lorenzopampaloni/Heliostat-system/hardware/photos/electronics_photos/arduino_and_drivers.JPG

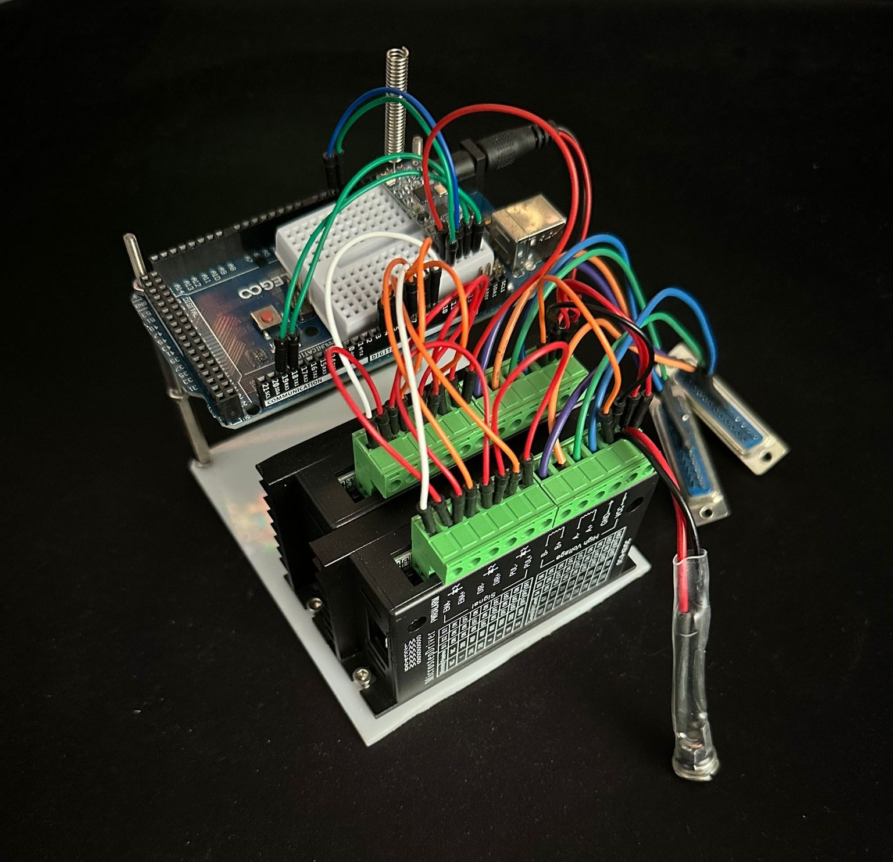
hardware/photos/electronics_photos/arduino_and_drivers.JPG
