lorenzopampaloni/Heliostat-system/hardware/photos/electronics_photos/Pc_HC12.JPG

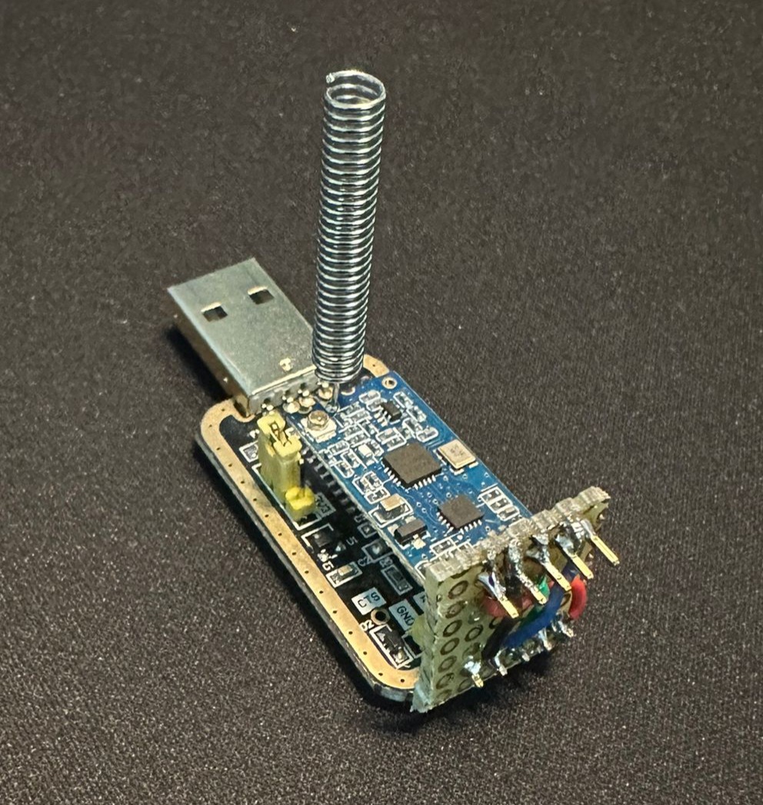
hardware/photos/electronics_photos/Pc_HC12.JPG
