lorenzopampaloni/Heliostat-system/hardware/photos/system_photos/System_frontview.JPG

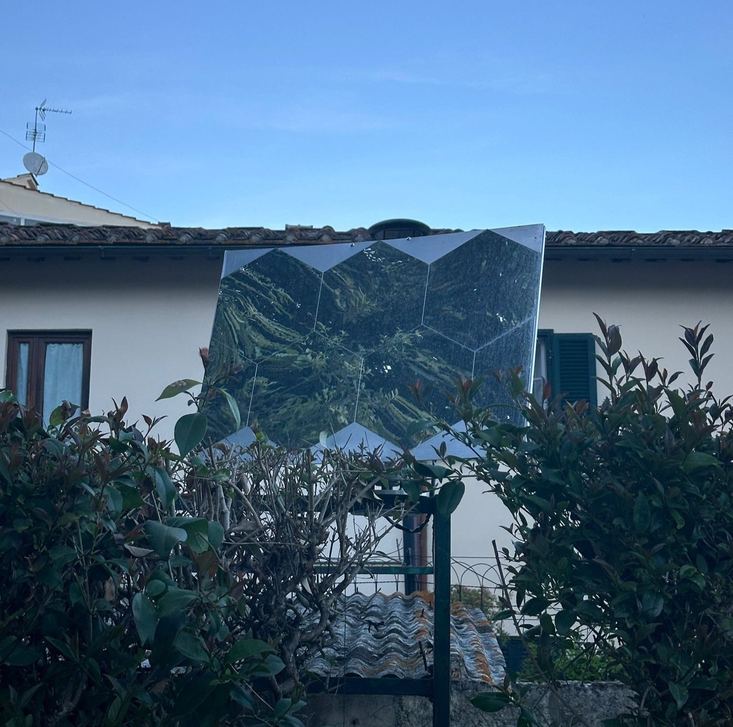
hardware/photos/system_photos/System_frontview.JPG
