lorenzopampaloni/Heliostat-system/hardware/wiring.drawio.png

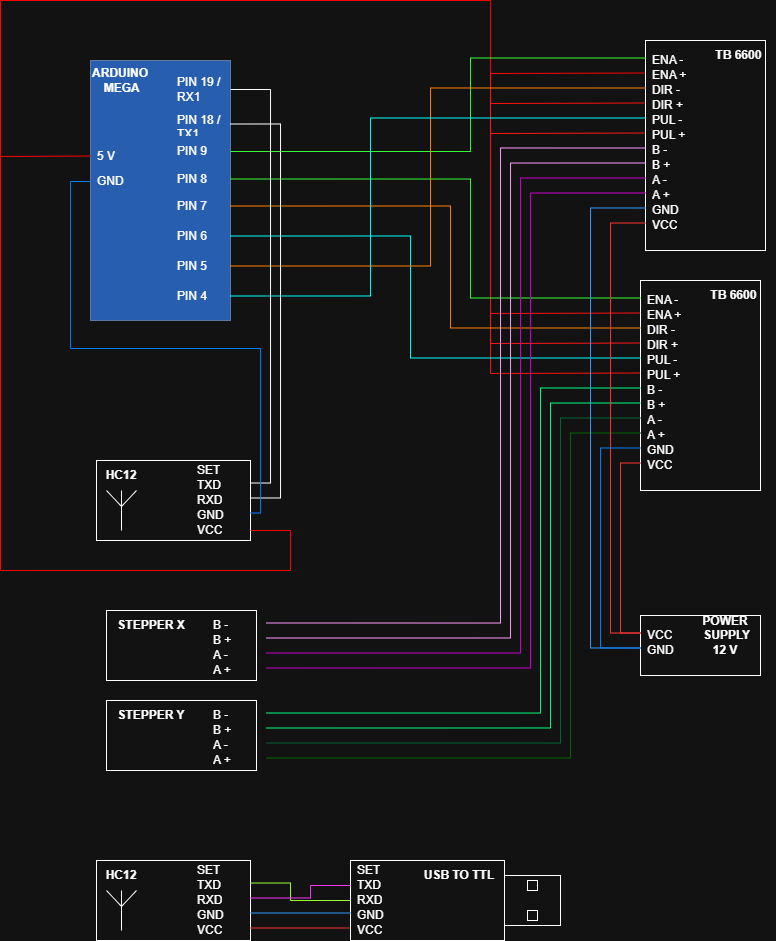
hardware/wiring.drawio.png
