lorenzopampaloni/Heliostat-system/(commit log)

2026-04-15 Document how the heliostat system works
    Added detailed documentation on the heliostat system's operation, including principles of reflection geometry, sun position computation, target definition, motor angle conversion, control flow, and backlash mitigation strategies.
2026-04-15 Add README for Arduino firmware documentation
    This README provides detailed documentation for the Arduino Mega firmware, including hardware interfaces, command execution, serial protocols, and system limitations.
2026-04-15 Add firmware for stepper motor control
    Implement basic motion control for stepper motors with serial command parsing.
2026-04-15 Add detailed hardware documentation to README
    This README provides a comprehensive overview of the hardware components used in the heliostat system, detailing the electronics, actuation, transmission, mechanical structure, mirror system, backlash mitigation, wiring, photos, mechanical fabrication, design considerations, and a summary of the hybrid system.
2026-05-03 Add Wiring section to README
2026-05-03 added wiring
2026-05-03 Update Wiring link to point to wiring.drawio
2026-05-03 Update Wiring link to use PNG format
2026-05-03 Update wiring diagram reference in HOW_TO_RUN.md
2026-05-03 Fix formatting for wiring diagram link in HOW_TO_RUN.md
2026-05-03 Fix formatting in HOW_TO_RUN.md for wiring reference
